DevPauloV/Painel_de_Senha/README.md

# Painel_de_Senha
Projeto feito com PIC16f690 e 4511 para simular um painel de senha de hospital.

 Neste projeto deve-se desenvolver um painel de senhas para atendimento de pessoas em uma empresa.
 </br>
             O painel deverá mostrar senhas de atendimento de 0 a 99 para letras A e E, deverá ser mostrado também o número do guichê ao qual o cliente deverá se dirigir.
             </br>
             O controle deverá ser feito através de sinais de entrada no microcontrolador através de botões:</br>
•	Controle de senha:</br>
o	Senha tipo A</br>
o	Senha tipo E</br>
o	Incremento</br>
o	Reset </br>
o	Sinal sonoro (buzzer)</br>
•	Guichê:</br>
o	1, 2, 3 e 4.</br>
•	O incremento e o reset devem ser realizados para os tipos de senha A e E individualmente. Sendo mostrado nos displays sempre o último valor em cada tipo. Para incrementar ou resetar as senhas do tipo A, deve-se primeiro pressionar o botão referente a A e em seguida o botão incremento ou reset, segue-se o mesmo critério para senhas do tipo E.</br>
•	No caso dos guichês cada botão mostra os valores individualmente, um botão para o guichê 1 e outros botões para 2, 3 e 4.</br>
