DevPauloV/Painel_de_Senha/(list of files, drawings)

Other design files:
SENHA.DSN
